ritam0210/Weather_Station/DPR/WhatsApp Image 2024-03-15 at 12.02.14 PM (1).jpeg

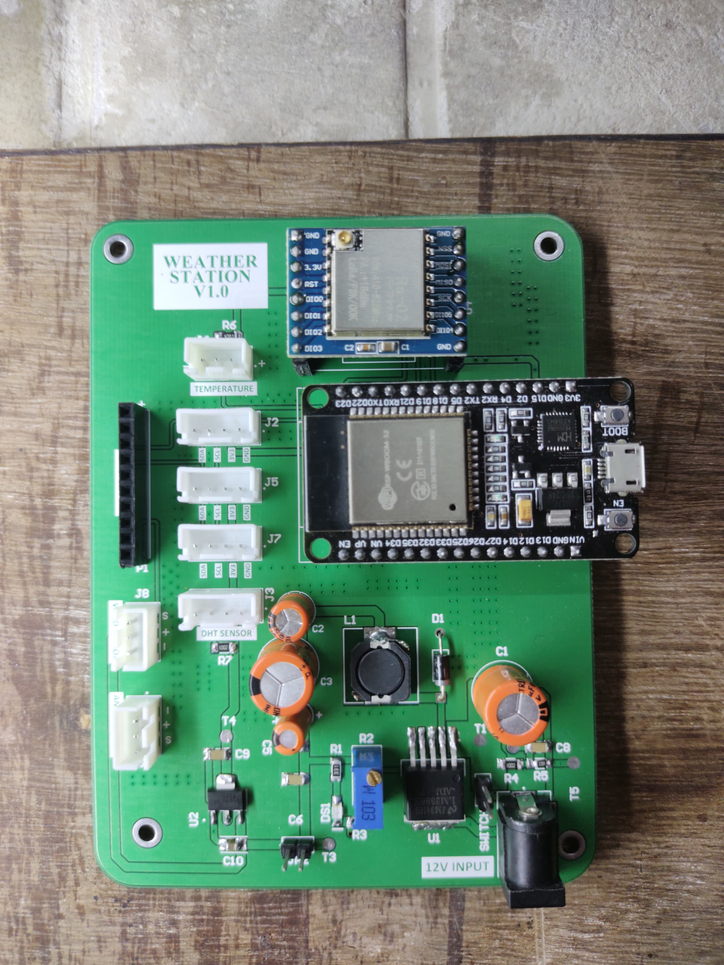
DPR/WhatsApp Image 2024-03-15 at 12.02.14 PM (1).jpeg
