ritam0210/Weather_Station/Documentation/FINAL_YEAR_REPORT.docx

TABLE OF CONTENTS

Abstract

CHAPTER 1

Introduction

CHAPTER 2

Objectives of the study

CHAPTER 3

Literature Review

CHAPTER 4

System Architecture

4.1 Workflow

4.2 Hardware implementation

4.2.1 A3144 Magnetic Hall Sensor

4.2.2 DS18B20 Temperature Sensor

4.2.3 DHT22 Temperature and Humidity Sensor

4.2.4 GY-30 BH1750FVI Light Sensor

4.2.5 GY-BME280 Atmospheric Pressure Sensor

4.2.6 DFRobot LTR390 UV Light Sensor

4.5.7 SX1278 LoRa Module

4.3 Software Implementation

4.3.1

CHAPTER 5

Unique Propositions of the project

CHAPTER 6

Result Analysis

CHAPTER 7

Future scope of the project

CHAPTER 8

Conclusion

Appendix

Bibliography
