ritam0210/Weather_Station/DPR/Project Title.docx

**Project Title: Development of Anemometer and Wind Vane Sensors**

**1. Executive Summary:**

The project aims to design, develop, and deploy anemometer and wind vane sensors for accurate measurement of wind speed and direction. These sensors are crucial for various applications including weather monitoring, renewable energy systems, agriculture, aviation, and environmental research. The project will focus on creating reliable, durable, and cost-effective sensors that can be deployed in diverse environmental conditions.

**2. Introduction:**

Wind speed and direction are vital parameters for numerous applications. Anemometers measure wind speed while wind vanes determine wind direction. Traditional methods involve mechanical sensors prone to wear and inaccuracies. The proposed project seeks to develop advanced sensors using modern electronic and material science technologies to overcome these limitations.

**3. Objectives:**

- Design and develop an anemometer capable of accurately measuring wind speed.

- Design and develop a wind vane sensor capable of precisely determining wind direction.

- Implement robust and reliable electronic circuitry to process sensor data.

- Ensure compatibility with existing weather monitoring systems.

- Conduct thorough testing to validate sensor accuracy and reliability.

- Develop a cost-effective manufacturing process for mass production.

**4. Methodology:**

4.1 **Design Phase:**

- Research existing sensor technologies and materials suitable for anemometer and wind vane construction.

- Conceptualize sensor designs considering factors such as accuracy, durability, power consumption, and cost.

- Utilize CAD software for detailed design and simulation.

- Select appropriate electronic components and circuitry for data acquisition and processing.

4.2 **Development Phase:**

- Fabricate prototype sensors based on finalized designs.

- Assemble electronic circuits and integrate them with sensor components.

- Implement calibration procedures to ensure accuracy.

- Conduct iterative testing and refinement to optimize sensor performance.

4.3 **Testing Phase:**

- Subject sensors to controlled wind conditions in a laboratory setting.

- Compare sensor readings with established reference standards.

- Assess sensor performance under various environmental conditions (e.g., temperature, humidity).

- Conduct field tests to evaluate long-term reliability and durability.

**5. Results and Discussion:**

- Detailed analysis of sensor performance including accuracy, precision, response time, and reliability.

- Comparison of sensor data with reference measurements demonstrating alignment.

- Identification of any limitations or areas for improvement.

- Discussion on potential applications and benefits of the developed sensors.

**6. Conclusion:**

The project successfully developed anemometer and wind vane sensors capable of accurately measuring wind speed and direction. These sensors offer significant improvements over traditional mechanical systems in terms of accuracy, reliability, and durability. The developed sensors have broad applications across various industries including meteorology, renewable energy, agriculture, and aviation.

**7. Future Scope:**

- Explore opportunities for miniaturization and integration with IoT platforms for remote monitoring.

- Enhance sensor capabilities for extreme weather conditions and harsh environments.

- Investigate the potential for integrating additional sensors (e.g., temperature, humidity) for comprehensive weather monitoring.

- Collaborate with industry partners for commercialization and widespread adoption of developed sensors.

**8. References:**

- List of academic papers, research articles, patents, and technical documents consulted during the project.

**9. Appendices:**

- Detailed schematics, CAD designs, and technical specifications of developed sensors.

- Test data and analysis reports.

- Photographs and videos documenting the development process.

This detailed project report provides comprehensive insights into the development of anemometer and wind vane sensors, outlining the methodology, results, and future directions for further research and development.
