ritam0210/Weather_Station/DPR/Wind_sensor.docx

1. Introduction

Anemometers are instruments used for measuring wind speed and direction. They are crucial tools in various fields such as meteorology, environmental monitoring, aviation, and industrial applications. This detailed project report outlines the design, construction, and functionality of an anemometer.

2. Objective

The primary objective of this project is to design and develop a low-cost yet accurate anemometer that can measure wind speed and direction reliably.

3. Components Required

- Propeller assembly
- Shaft
- Bearings
- Frame or support structure
- Electronic sensors (e.g., Hall Effect sensors)
- Microcontroller
- Display unit (LCD or LED)
- Power source (battery or external power supply)
- Wiring and connectors
- Enclosure (optional, for protection against environmental factors)

4. Design and Construction

4.1 Cup or Propeller Assembly: This component consists of cups or a propeller mounted on a shaft. The cups catch the wind, causing the assembly to rotate. The rotation speed is directly proportional to the wind speed.

4.2 Wind Vane: The wind vane is a device that indicates the direction of the wind. It is typically mounted perpendicular to the cup assembly to accurately determine wind direction.

4.3 Electronic Sensors: Hall Effect sensors can be used to detect the rotation of the cup assembly. These sensors generate electrical signals as the cups pass by, which are then processed to determine wind speed.

4.4 Microcontroller: A microcontroller such as Arduino or Raspberry Pi can be used to process the signals from the sensors, calculate wind speed and direction, and control the display unit.

4.5 Display Unit: The display unit can be an LCD screen or LED display that shows real-time wind speed and direction readings.

4.6 Power Source: The anemometer can be powered by batteries or an external power supply, depending on the application and location.

4.7 Enclosure: An enclosure may be used to protect the electronic components from environmental factors such as rain, dust, and temperature fluctuations.

5. Working Principle

- The cup or propeller assembly rotates when exposed to wind.
- The rotation is detected by the electronic sensors (Hall Effect sensors), which generate electrical signals.
- These signals are processed by the microcontroller to calculate the wind speed based on the rotation speed of the cup assembly.
- The wind vane determines the direction of the wind, which is also processed by the microcontroller.
- The calculated wind speed and direction are displayed on the display unit in real-time.

6. Calibration and Testing

Calibration is essential to ensure the accuracy of the anemometer. This involves comparing the readings of the anemometer with those of a calibrated instrument under various wind conditions. Adjustments may be made to the software algorithms to improve accuracy if necessary.

Testing involves subjecting the anemometer to different wind speeds and directions to verify its performance and reliability.

7. Conclusion

In conclusion, this project aims to develop an efficient and cost-effective anemometer for measuring wind speed and direction. By utilizing basic components and electronic sensors along with a microcontroller, accurate readings can be obtained in real-time. Regular calibration and testing are crucial to maintain the accuracy and reliability of the anemometer.
