ritam0210/Weather_Station/Documentation/FINAL YEAR PROJECT.docx

TABLE OF CONTENTS

ABSTRACT ……………………………………………………………………. IV

ACKNOWLEDGEMENT ……………………………………………………....V

TABLE OF CONTENTS………………………………………………………..VI

LIST OF INTERFACES………………………………………………………..VII

SENSOR INTERFACE DIAGRAM………………………………………….VIII

LIST OF EQUATIONS…………………………………………………………IX

LIST OF ACRONYMS………………………………………………………….X

CHAPTER 1 ………………………………

  1.1 INTRODUCTION……………………………………
  1.2 FEATURES………………………………………………………..
  1.3 SPECIFICATIONS………………………………………………………………
  1.4 PROBLEM DEFINITION…………………………………………
  1.5 RESEARCH OBJECTIVES……………………………………………..
  1.6 STRUCTURE OF THE THESIS……………………………………….
  1.7 VERSION- 2……………………………………………………..

CHAPTER 2……………………………………………………….

RELATED CONCEPTS AND LITERATURE REVIEW…………………….

2.1 INTRODUCTION……………………………………………..

2.2 DATABASES…………………………………………..

2.3 SUMMARY……………………………………..

CHAPTER 3……………………………………………………….

A3144 MAGNETIC HALL SENSOR……………………………..

3.1 FEATURES ……………………………..

3.2 SPECIFICATIONS……………………………..

3.3 DATASHEET…………………………………

CHAPTER 4………………………………………………………………..

DSI8B20 TEMPERATURE SENSOR…………………………….

4.1 FEATURES …………………..

4.2 SPECIFICATIONS …………………………………….

4.3 DATASHEET……………………………………………..

CHAPTER 5…………………………………………………………………

DHT22 TEMPERATURE AND HUMIDITY SENSOR (AM2302)……………

5.1 FEATURES………………………………………………

5.2 SPECFICATION……………………………………………

5.3 DATASHEET…………………………………………………..

CHAPTER 6…………………………………………………………

GY-30 BH1750FVI LIGHT SENSOR……………………………………………..

6.1 FEATURES…………………………………………………………………

6.2 SPECIFICATIONS…………………………………………………………………

6.3 DATASHEET………………………………………………………..

CHAPTER 7…………………………………………………………………..

GY-BME280 ATMOSPHERIC PRESSURE SENSOR………………………….

7.1 FEATURES………………………………………………………..

7.2 SPECIFICATIONS………………………………………………

7.3 DATASHEET……………………………………………….

CHAPTER 8………………………………………………………………

DFROBOT LTR390 UV LIGHT SENSOR……………………………………..

8.1 FEATURES…………………………………………………………

8.2 SPECIFICATIONS……………………………………………

8.3 DATASHEET…………………………………………………

CHAPTER 9……………………………………………………………….

SX1278 LORA MODULE……………………………………………………

9.1 FEATURES……………………………………………………..

9.2 SPECIFICATIONS………………………………………………

9.3 DATASHEET……………………………………………………….

CHAPTER 10……………………………………………………..

CONCLUSION AND FUTURE WORK………………………………..

10.1 INTRODUCTION…………………………………………….

10.2 CONCLUSION……………………………………………………..

10.3 LIMITATIONS……………………………………………….

10.4 THESIS CONTRIBUTIONS………………………………………..

10.5 FUTURE WORK…………………………………………………….

BIBLEOGRAPHY……………………………………………………………………..
