ritam0210/Weather_Station/Anemometer print files/Mounting plate Assembly.SLDASM

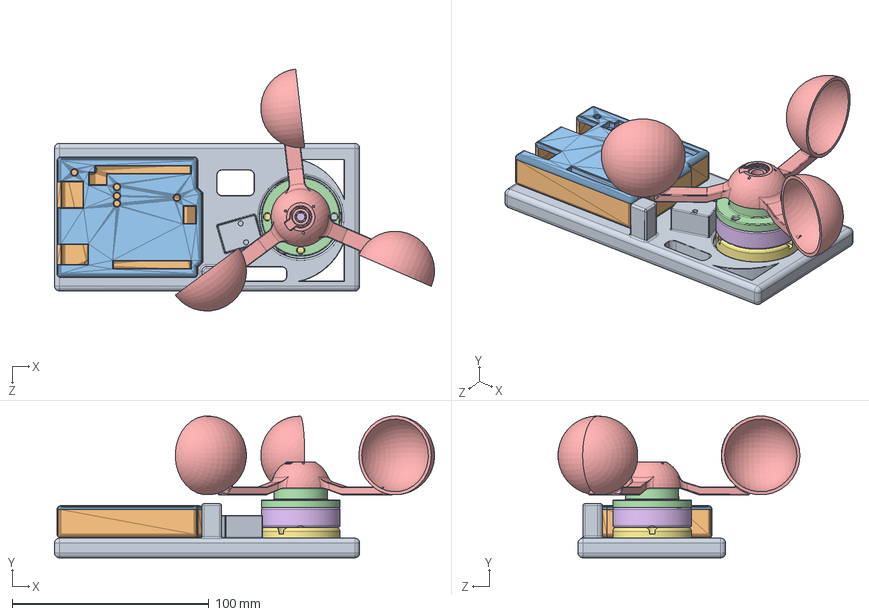
[picture p25: CAD file, 2024-04-18]
Anemometer print files/Mounting plate Assembly.SLDASM
193.0 x 72.0 x 122.9 mm
Mounting Plate
arduino_uno_bottom
arduino_uno_top
Anemometer Connecting Base
Wind speed Anemometer
Bearing Connection
Base Bearing Connection
