ritam0210/Weather_Station/Anemometer print files/Anemometer Assembly.SLDASM

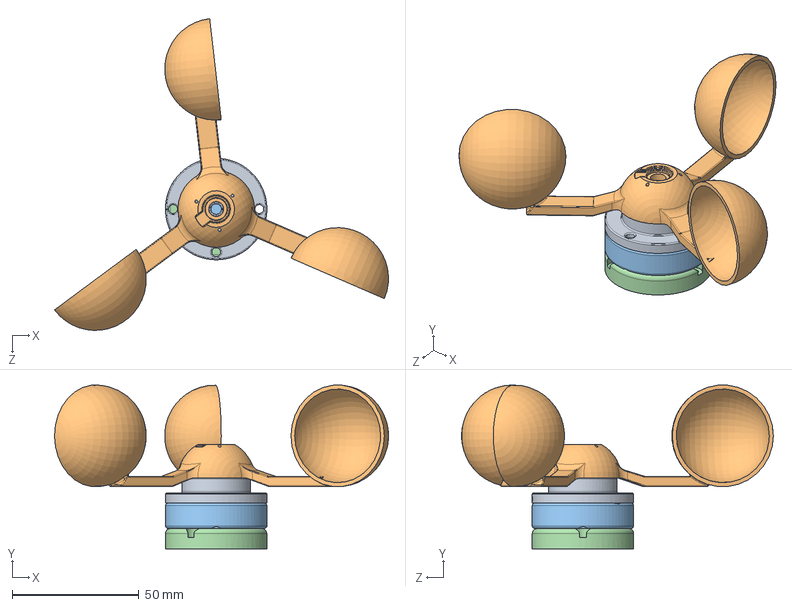
[picture p26: CAD file, 2024-04-18]
Anemometer print files/Anemometer Assembly.SLDASM
131.7 x 64.5 x 122.9 mm
Anemometer Connecting Base
Wind speed Anemometer
Bearing Connection
Base Bearing Connection
