ritam0210/Weather_Station/Anemometer print files/Wind speed Anemometer.SLDPRT

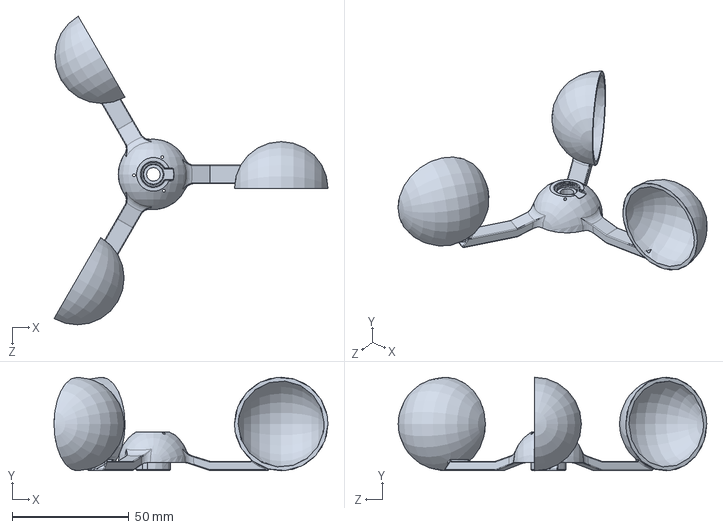
[picture p27: CAD file, 2024-04-18]
Anemometer print files/Wind speed Anemometer.SLDPRT
117.5 x 40.1 x 132.4 mm
