ritam0210/Weather_Station/CAD Files/Anaemometer.stl

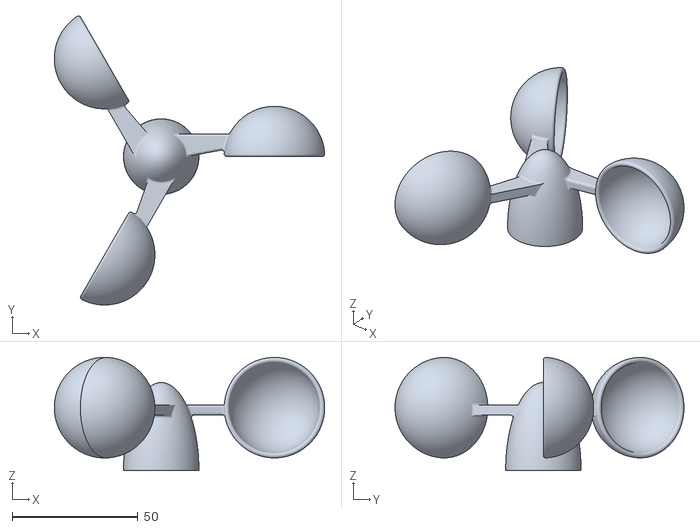
[picture p28: CAD file, 2024-04-18]
CAD Files/Anaemometer.stl
107.5 x 114.9 x 45.0
