ritam0210/Weather_Station/Anemometer print files/Anemometer Connecting Base.SLDPRT

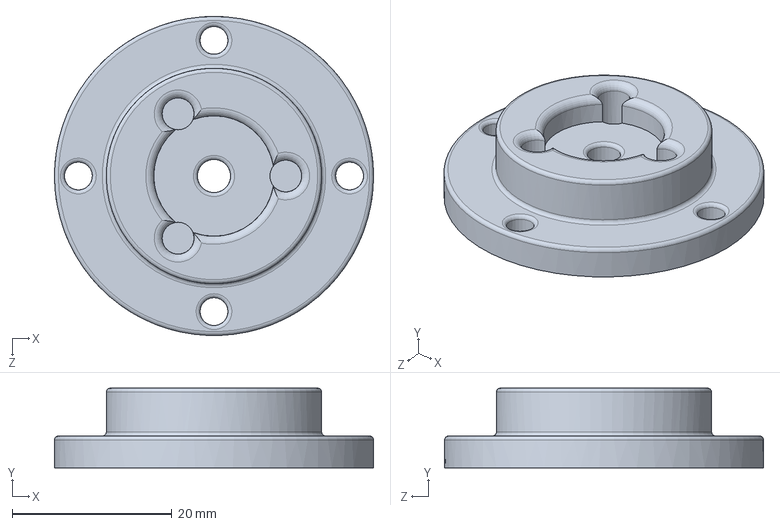
[picture p29: CAD file, 2024-04-18]
Anemometer print files/Anemometer Connecting Base.SLDPRT
40.0 x 10.0 x 40.0 mm
