ritam0210/Weather_Station/CAD Files/Base.stl

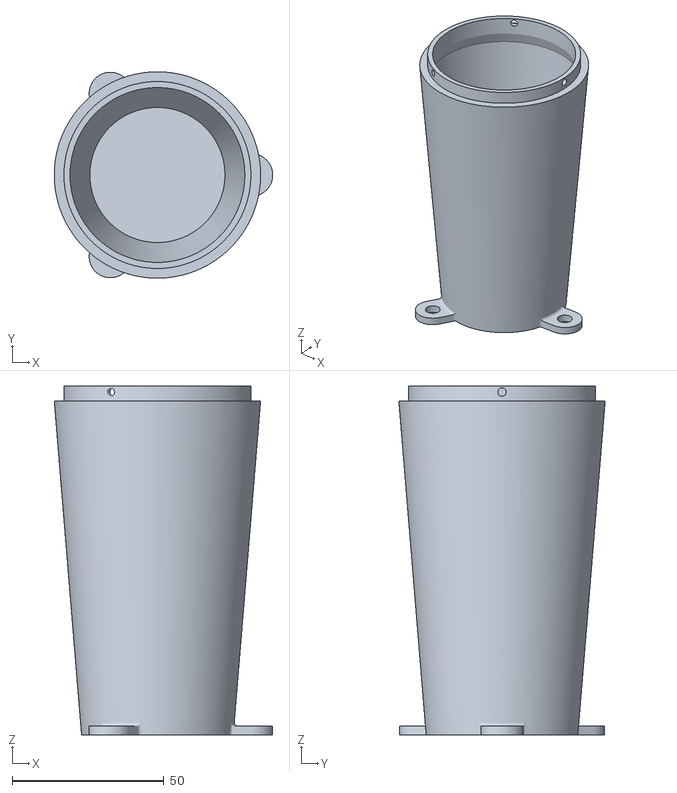
[picture p30: CAD file, 2024-04-18]
CAD Files/Base.stl
72.0 x 68.0 x 115.0
