ritam0210/Weather_Station/Anemometer print files/Mounting Plate.SLDPRT

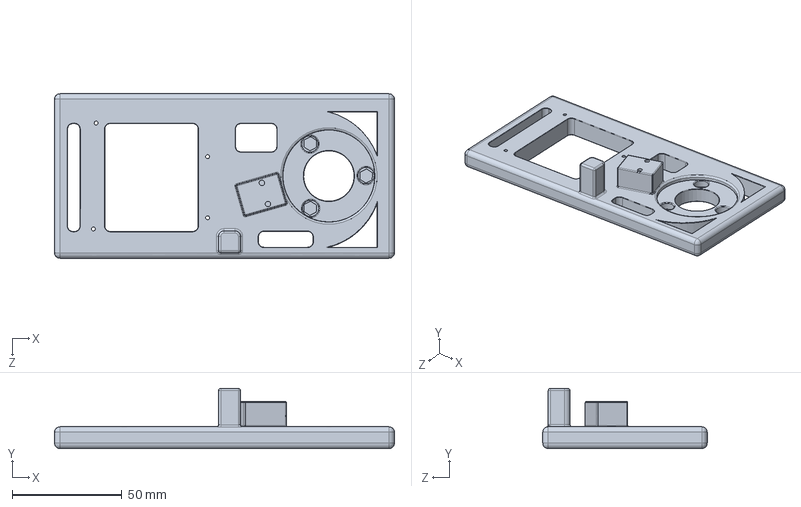
[picture p31: CAD file, 2024-04-18]
Anemometer print files/Mounting Plate.SLDPRT
155.0 x 27.5 x 75.0 mm
