ritam0210/Weather_Station/CAD Files/Sensor Holder.stl

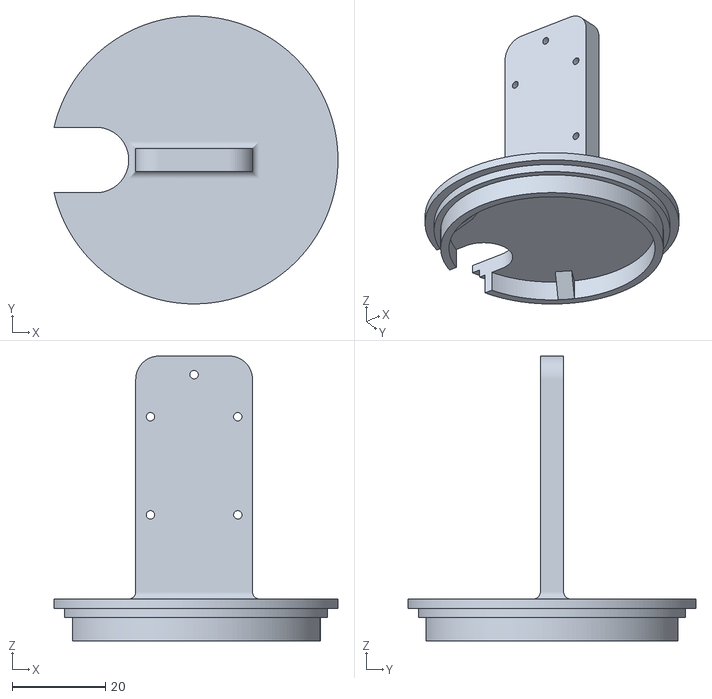
[picture p32: CAD file, 2024-04-18]
CAD Files/Sensor Holder.stl
60.8 x 61.6 x 61.0
