ritam0210/Weather_Station/Anemometer print files/Base Bearing Connection.SLDPRT

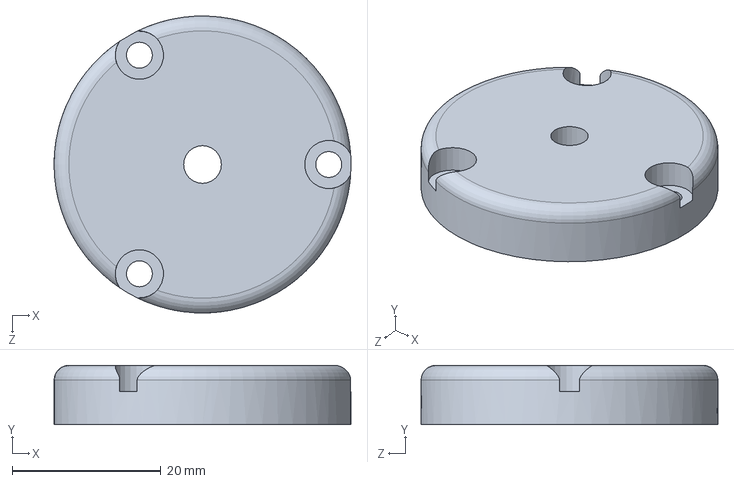
[picture p33: CAD file, 2024-04-18]
Anemometer print files/Base Bearing Connection.SLDPRT
40.0 x 8.00 x 40.0 mm
