ritam0210/Weather_Station/Anemometer print files/Bearing Connection.SLDPRT

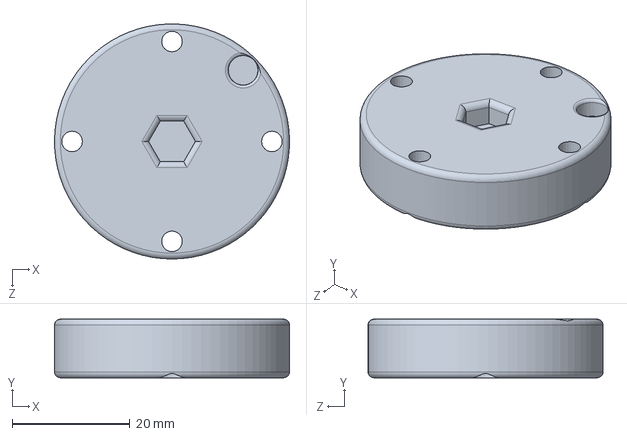
[picture p34: CAD file, 2024-04-18]
Anemometer print files/Bearing Connection.SLDPRT
40.0 x 10.0 x 40.0 mm
