ritam0210/Weather_Station/(list of files, cad)

Other CAD files:
Anemometer print files/Anemometer Connecting Base.STL
Anemometer print files/Base Bearing Connection.STL
Anemometer print files/Bearing Connection.STL
Anemometer print files/Mounting Plate.STL
Anemometer print files/Wind speed Anemometer.STL
