ritam0210/Weather_Station/Documentation/Weather_Stn_SCH.pdf

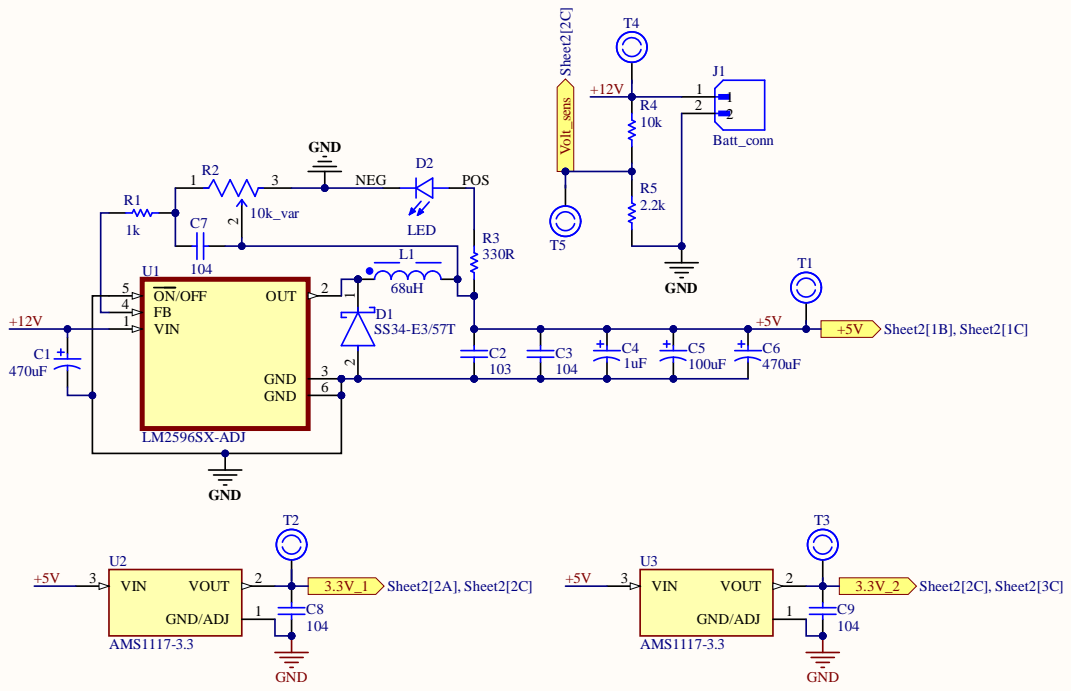
[picture p35: page 1]

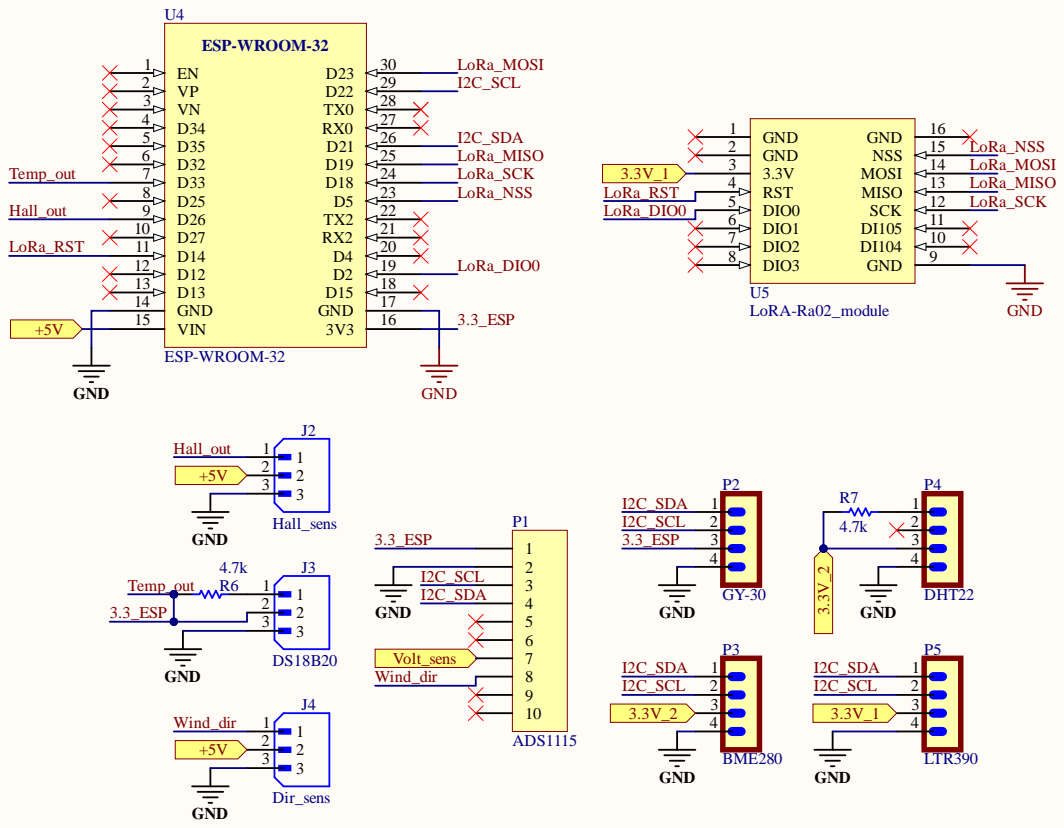
[picture p36: page 2]
